YutaSeya/rokisi/hardware/3Dデータ.stl

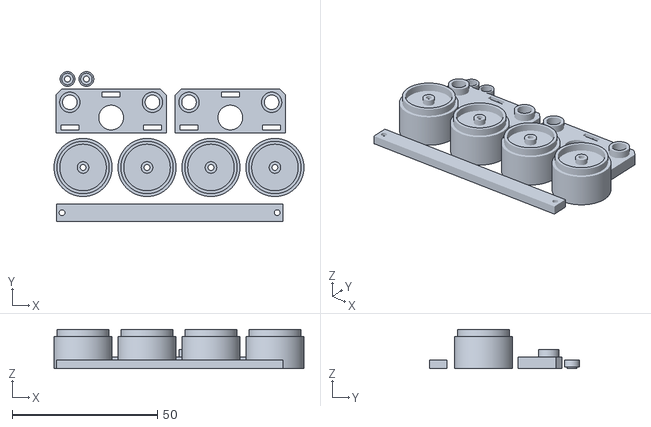
[picture p1: CAD file, 2020-04-21]
hardware/3Dデータ.stl
86.0 x 51.5 x 13.5
