YutaSeya/rokisi/hardware/rokisi/rokisi.pdf

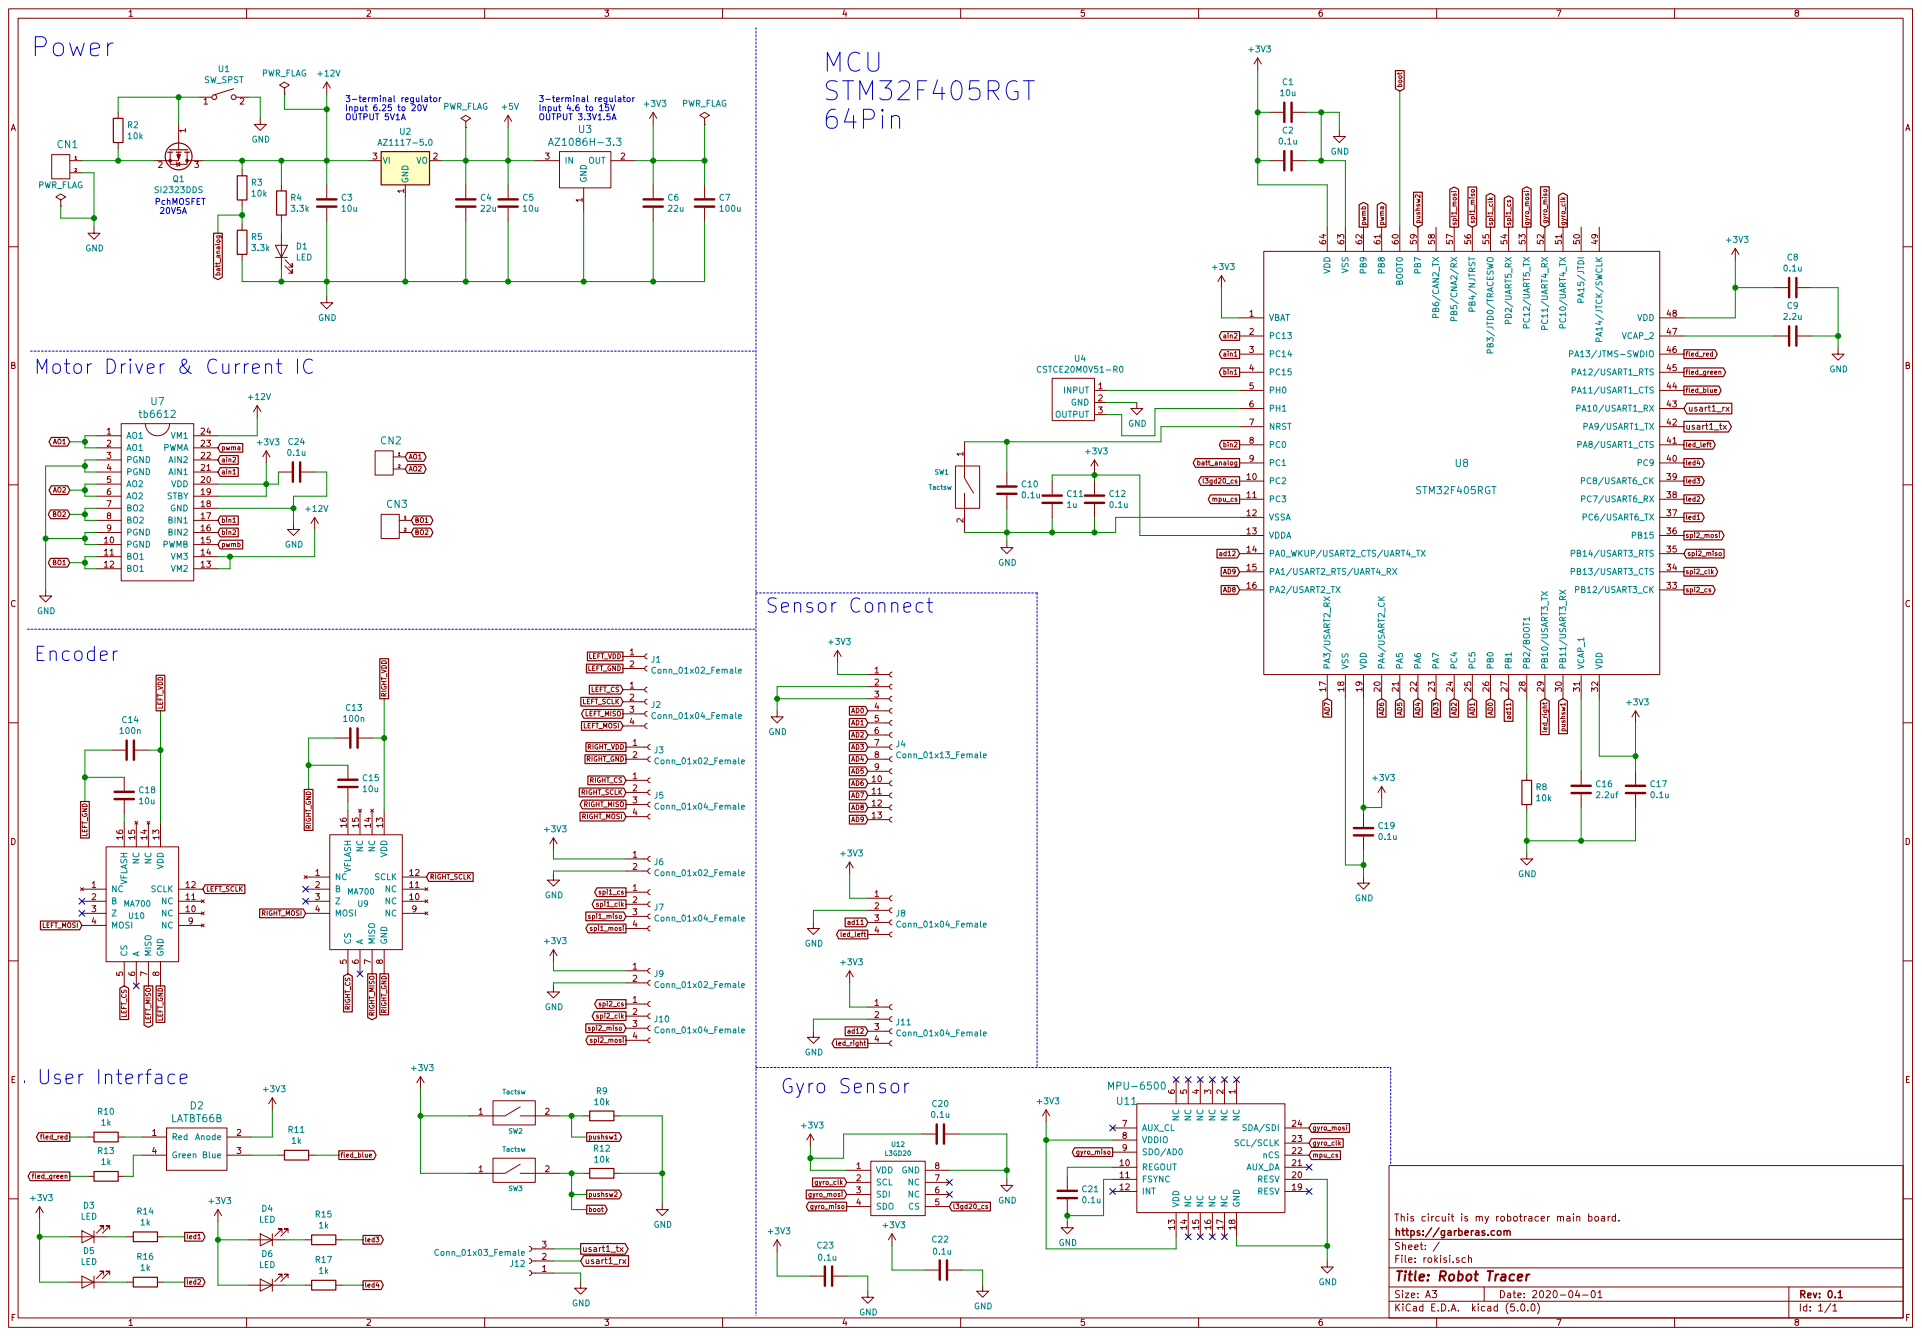
[picture p2: page 1]

bin2 GND Motor Driver & Current IC

This circuit is my robotracer main board.
Id: 1/1 Title: Robot Tracer File: rokisi.sch Sheet: / https://garberas.com
