YutaSeya/rokisi/hardware/rokisi_sensor/rokisi_sensor.pdf

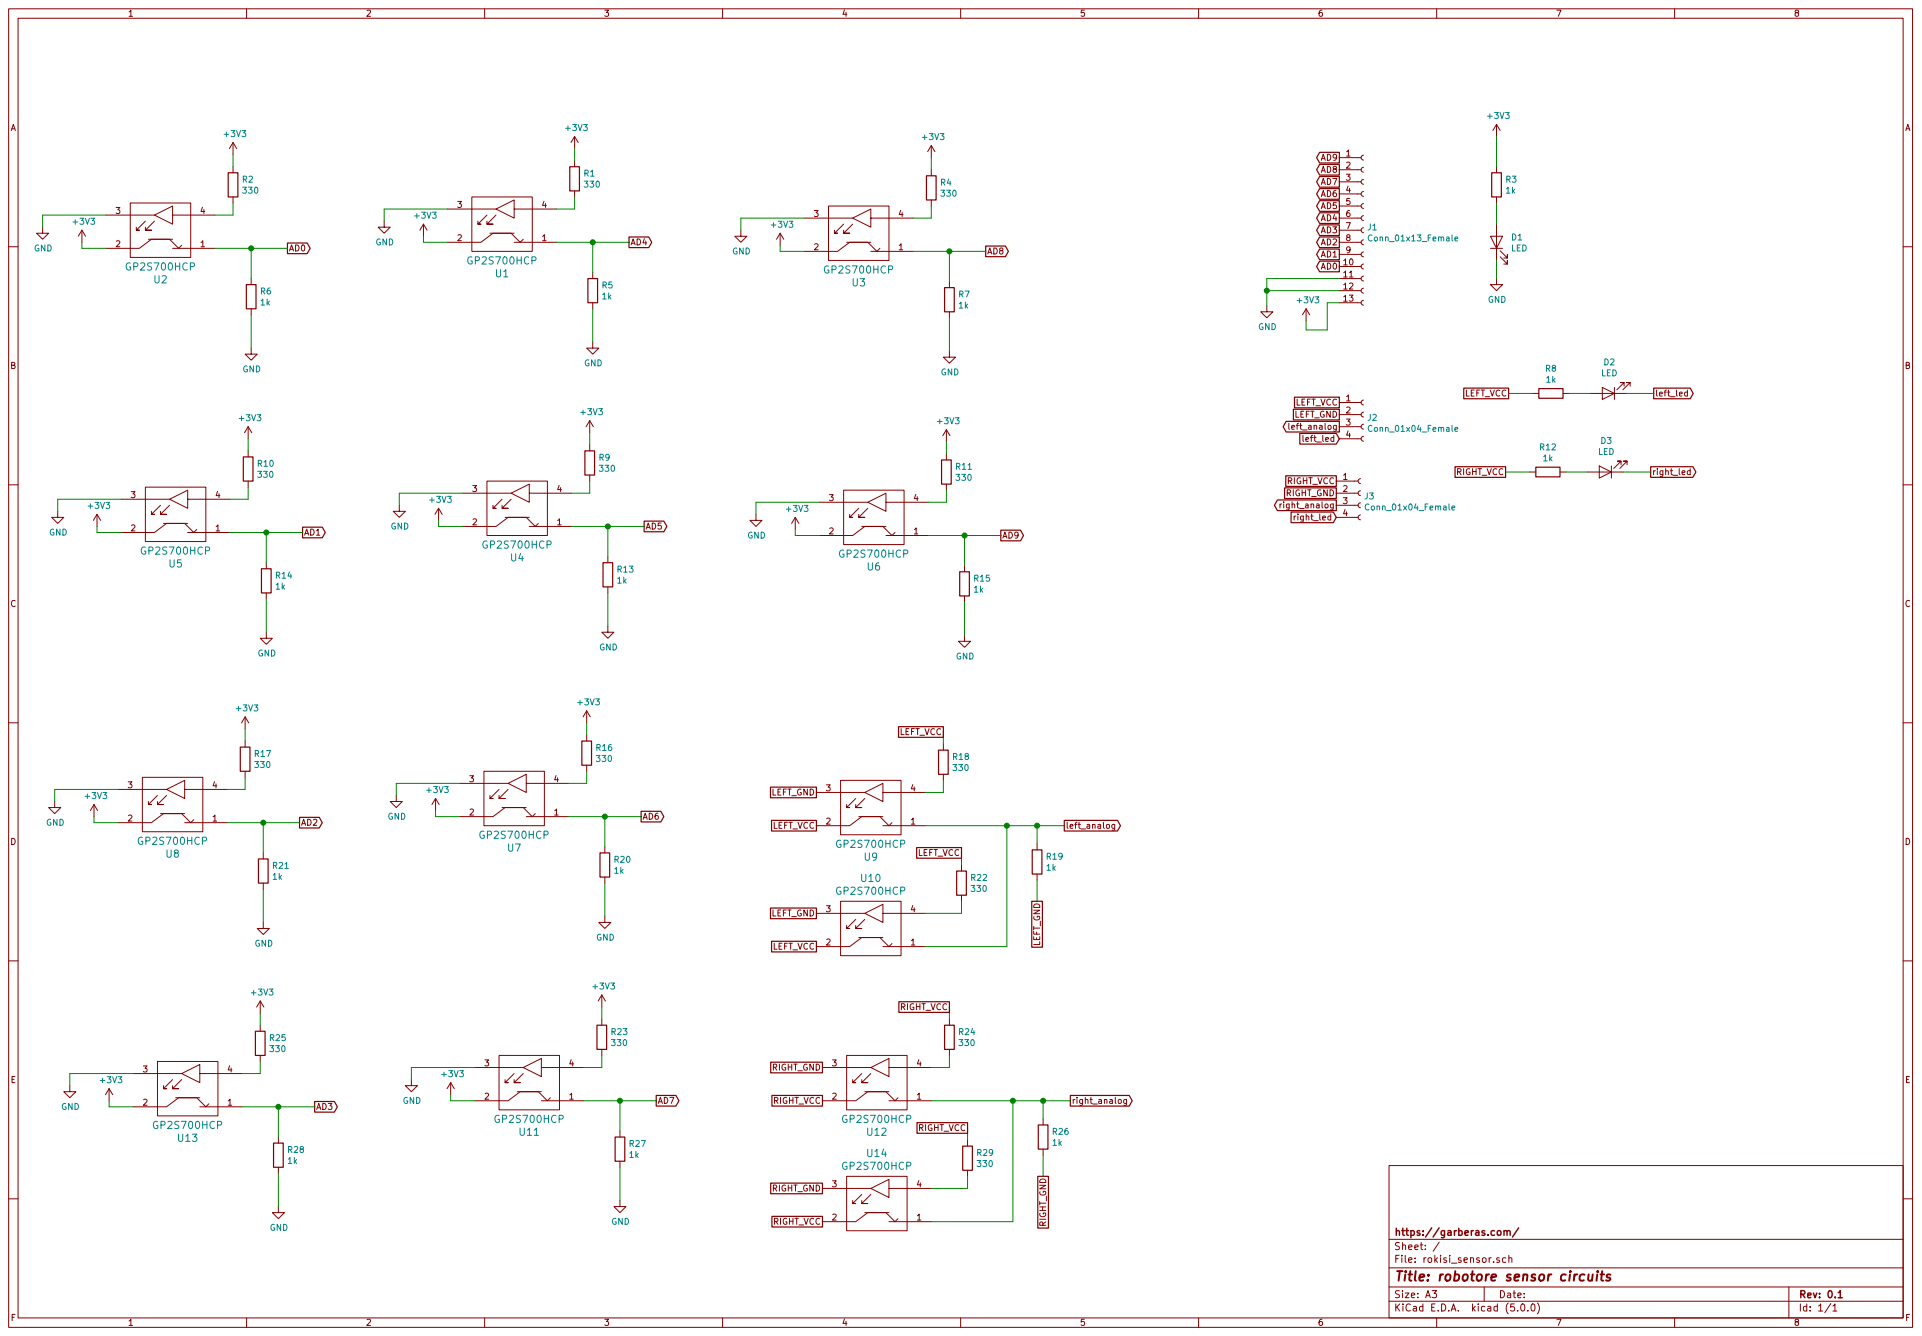
[picture p3: page 1]

File: rokisi_sensor.sch Sheet: / https://garberas.com/

Id: 1/1 Title: robotore sensor circuits
