YutaSeya/rokisi/hardware/rokisi/rokisi.kicad_pcb

## KiCad design hardware/rokisi/rokisi.kicad_pcb (2020-04-18)

Schematic: rokisi.sch, Robot Tracer

Parts:
C1, C3, C5, C15, C18: 10u; C_0603_HandSoldering
C2, C8, C10, C12, C17, C19, C20, C21, C22, C23, C24: 0.1u; C_0603_HandSoldering
C4, C6: 22u; C_0603_HandSoldering
C7: 100u; C_1206_HandSoldering
C9: 2.2u; C_0603_HandSoldering
C11: 1u; C_0603_HandSoldering
C13, C14: 100n; C_0603_HandSoldering
C16: 2.2uf; C_0603_HandSoldering
CN1: CONNECT; Pin_Header_Straight_1x02_Pitch2.54mm
CN2, CN3: CONNECT; Pin_Header_Straight_1x02_Pitch2.00mm
D1: LED; LED_0603_HandSoldering
D2: LATBT66B
D3, D4, D5, D6: LED; LED_0603_HandSoldering_silk
J1, J3, J6, J9: Conn_01x02_Female; enckiban_robotore_pad2
J2, J5, J7, J10: Conn_01x04_Female; enckiban_pad4
J4: Conn_01x13_Female; FFC-SMD_13P-P0.50_X05B20U13T
J8, J11: Conn_01x04_Female; Pin_Header_Straight_1x04_Pitch2.00mm
J12: Conn_01x03_Female; Pin_Header_Straight_1x03_Pitch2.54mm
Q1: SI2323DDS; SOT-23_Handsoldering
R2, R3, R8, R9, R12: 10k; R_0603_HandSoldering
R4, R5: 3.3k; R_0603_HandSoldering
R10, R11, R13, R14, R15, R16, R17: 1k; R_0603_HandSoldering
SW1: Tactsw; B3U-1000P
SW2, SW3: Tactsw; SKRPACE010
U1: SW_SPST; PCM12SMTR
U2: AZ1117-5.0; SOT-223
U3: AZ1086H-3.3; SOT-223
U4: CSTCE20M0V51-R0; CSTCE12M0G52A-R0_HandSolding
U7: tb6612; SSOP-24_5.3x8.2mm_Pitch0.65mm
U8: STM32F405RGT; LQFP-64_10x10mm_Pitch0.5mm
U9, U10: MA700; QFN-16_3x3mm_Pitch0.5mm
U11: MPU-6500; QFN-24_3x3mm_Pitch0.4mm_silk
U12: L3GD20

Connections:
+3V3: C1.2, C2.2, C6.1, C7.1, C8.2, C11.1, C12.1, C17.1, C19.2, C20.2, C22.1, C23.1, C24.2, D2.2, D3.2, D4.2, D5.2, D6.2, J4.1, J6.1, J8.1, J9.1, J11.1, SW2.1, SW3.1, U3.2, U3.4, U7.19, U7.20, U8.1, U8.13, U8.19, U8.32, U8.48, U8.64, U11.8, U11.13, U12.1
+5V: C4.1, C5.1, U2.2 (VO), U2.4, U3.3
+12V: C3.1, Q1.3 (D), R3.1, R4.1, U2.3 (VI), U7.13, U7.14, U7.24
AD0: J4.4, U8.26
AD1: J4.5, U8.25
AD2: J4.6, U8.24
AD3: J4.7, U8.23
AD4: J4.8, U8.22
AD5: J4.9, U8.21
AD6: J4.10, U8.20
AD7: J4.11, U8.17
AD8: J4.12, U8.16
AD9: J4.13, U8.15
AO1: CN2.1, U7.1, U7.2
AO2: CN2.2, U7.5, U7.6
BO1: CN3.1, U7.11, U7.12
BO2: CN3.2, U7.7, U7.8
GND: C1.1, C2.1, C3.2, C4.2, C5.2, C6.2, C7.2, C8.1, C9.1, C10.1, C11.2, C12.2, C16.2, C17.2, C19.1, C20.1, C21.2, C22.2, C23.2, C24.1, CN1.2, D1.1, J4.2, J4.3, J6.2, J8.2, J9.2, J11.2, J12.1, R5.2, R8.2, R9.1, R12.1, SW1.2, U1.2, U2.1 (GND), U3.1, U4.2, U7.3, U7.4, U7.9, U7.10, U7.18, U8.12, U8.18, U8.63, U11.11, U11.18, U11.20, U12.8
LEFT_CS: J2.1, U10.5
LEFT_GND: C14.2, C18.1, J1.2, U10.8
LEFT_MISO: J2.3, U10.7
LEFT_MOSI: J2.4, U10.4
LEFT_SCLK: J2.2, U10.12
LEFT_VDD: C14.1, J1.1, U10.13
unnamed: C9.2, U8.47
unnamed: C10.2, SW1.1, U8.7
unnamed: C15.2, U9.16
unnamed: C16.1, U8.31
unnamed: C18.2, U10.16
unnamed: C21.1, U11.10
unnamed: CN1.1, Q1.2 (S), R2.2
unnamed: D1.2, R4.2
unnamed: D2.1, R10.2
unnamed: D2.3, R11.1
unnamed: D2.4, R13.2
unnamed: D3.1, R14.1
unnamed: D4.1, R15.1
unnamed: D5.1, R16.1
unnamed: D6.1, R17.1
unnamed: Q1.1 (G), R2.1, U1.1
unnamed: R8.1, U8.28
unnamed: U4.1, U8.5
unnamed: U4.3, U8.6
RIGHT_CS: J5.1, U9.5
RIGHT_GND: C13.2, C15.1, J3.2, U9.8
RIGHT_MISO: J5.3, U9.7
RIGHT_MOSI: J5.4, U9.4
RIGHT_SCLK: J5.2, U9.12
RIGHT_VDD: C13.1, J3.1, U9.13
ad11: J8.3, U8.27
ad12: J11.3, U8.14
ain1: U7.21, U8.3
ain2: U7.22, U8.2
batt_analog: R3.2, R5.1, U8.9
bin1: U7.17, U8.4
bin2: U7.16, U8.8
boot: R12.2, SW3.2, U8.59, U8.60
fled_blue: R11.2, U8.44
fled_green: R13.1, U8.45
fled_red: R10.1, U8.46
gyro_clk: U8.51, U11.23, U12.2
gyro_miso: U8.52, U11.9, U12.4
gyro_mosi: U8.53, U11.24, U12.3
l3gd20_cs: U8.10, U12.5
led1: R14.2, U8.37
led2: R16.2, U8.38
led3: R15.2, U8.39
led4: R17.2, U8.40
led_left: J8.4, U8.41
led_right: J11.4, U8.29
mpu_cs: U8.11, U11.22
pushsw1: R9.2, SW2.2, U8.30
pwma: U7.23, U8.61
pwmb: U7.15, U8.62
spi1_clk: J7.2, U8.55
spi1_cs: J7.1, U8.54
spi1_miso: J7.3, U8.56
spi1_mosi: J7.4, U8.57
spi2_clk: J10.2, U8.34
spi2_cs: J10.1, U8.33
spi2_miso: J10.3, U8.35
spi2_mosi: J10.4, U8.36
usart1_rx: J12.2, U8.43
usart1_tx: J12.3, U8.42

Notes on the sheet:
Power
Gyro Sensor
PchMOSFET 20V5A
3-terminal regulator Input 6.25 to 20V OUTPUT 5V1A
3-terminal regulator Input 4.6 to 15V OUTPUT 3.3V1.5A
Motor Driver & Current IC
Encoder
MCU STM32F405RGT 64Pin
User Interface
Sensor Connect

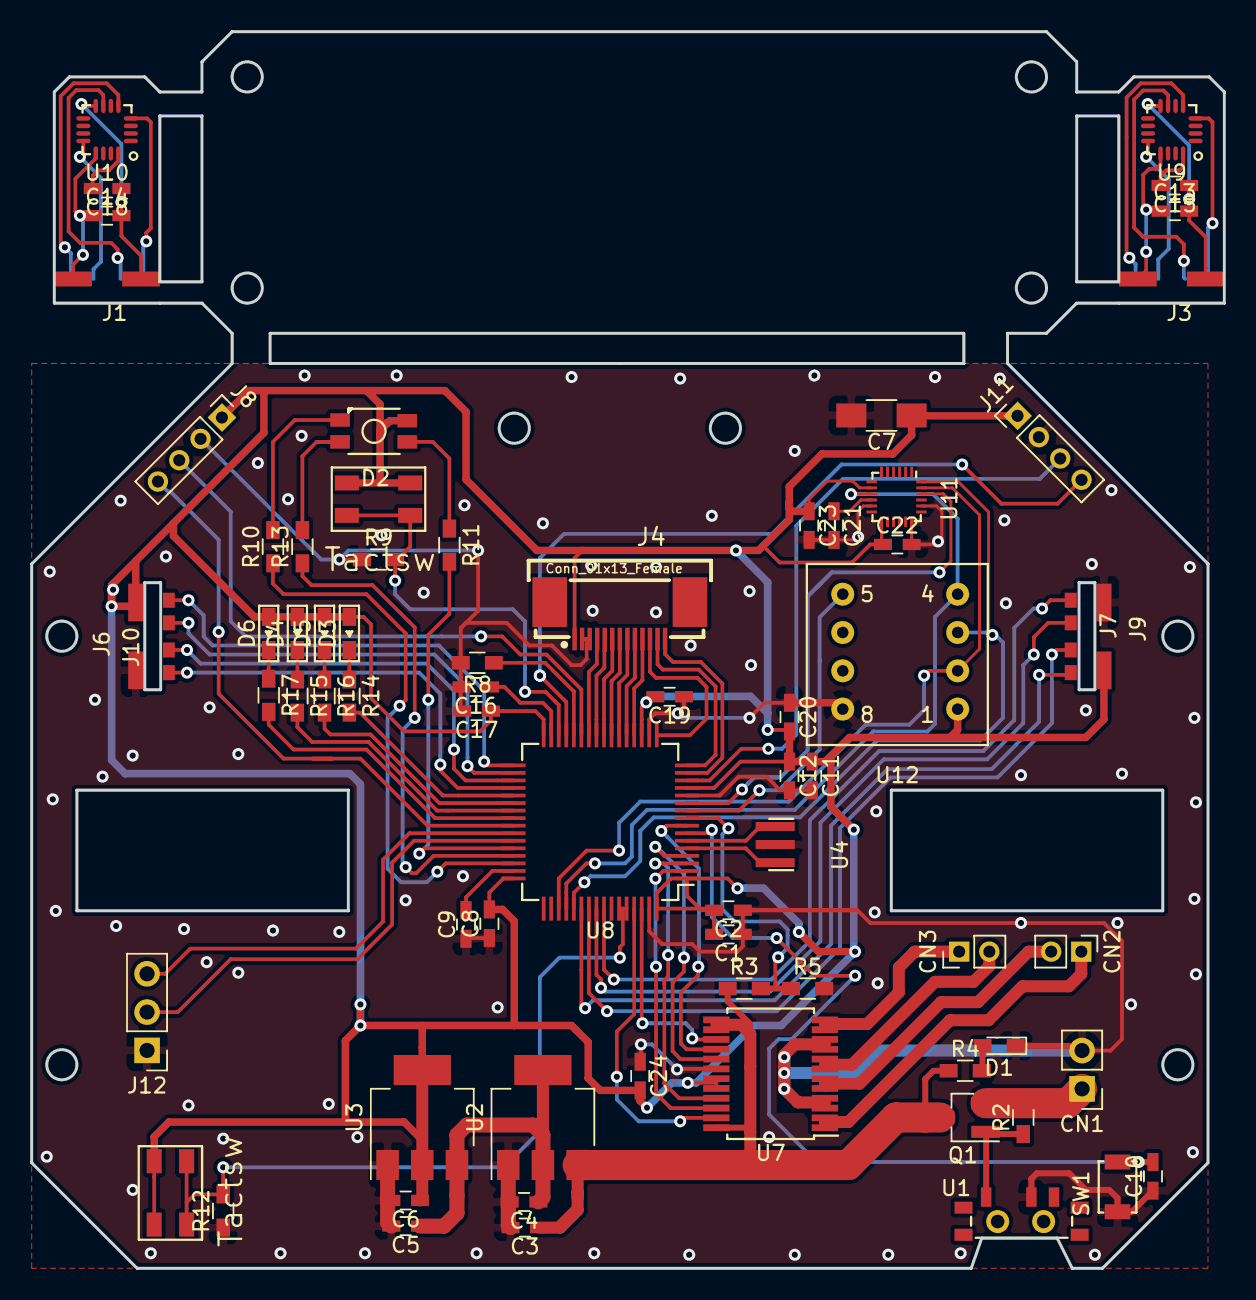
[picture p4: board rokisi.kicad_pcb from above]

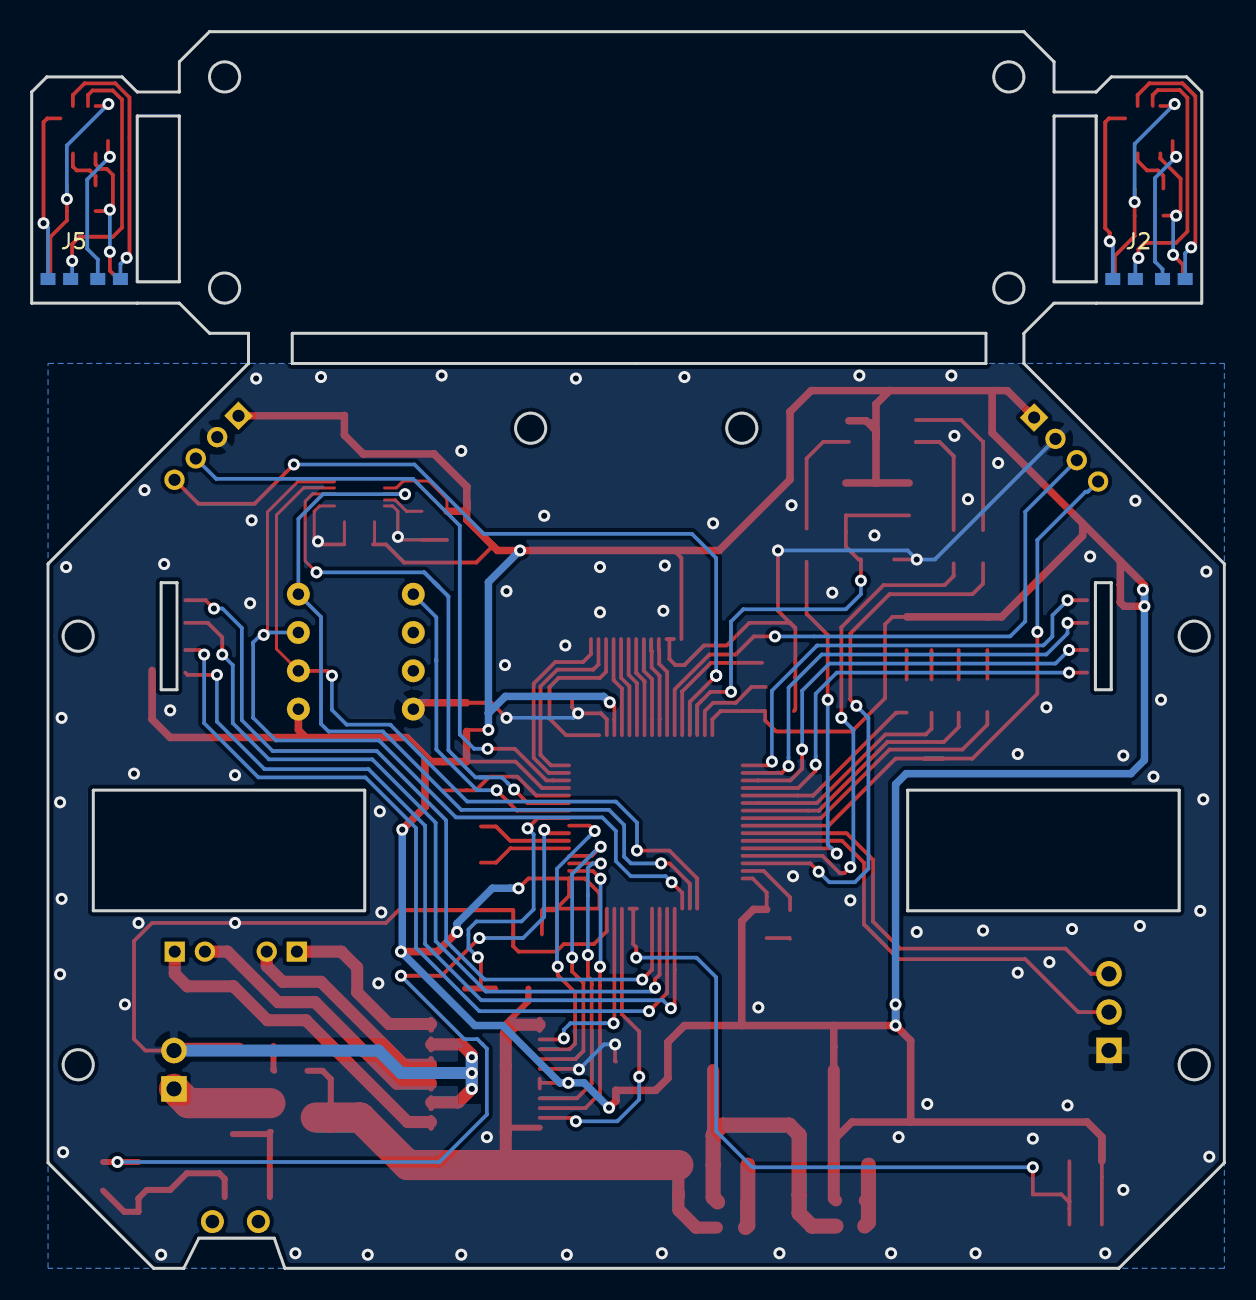
[picture p5: board rokisi.kicad_pcb from below]

Board: 2 copper layers, 79.1 x 82.0 mm, 73 parts (2 on the bottom side), 84 nets.
