YutaSeya/rokisi/hardware/rokisi_sensor/rokisi_sensor.kicad_pcb

## KiCad design hardware/rokisi_sensor/rokisi_sensor.kicad_pcb (2020-04-18)

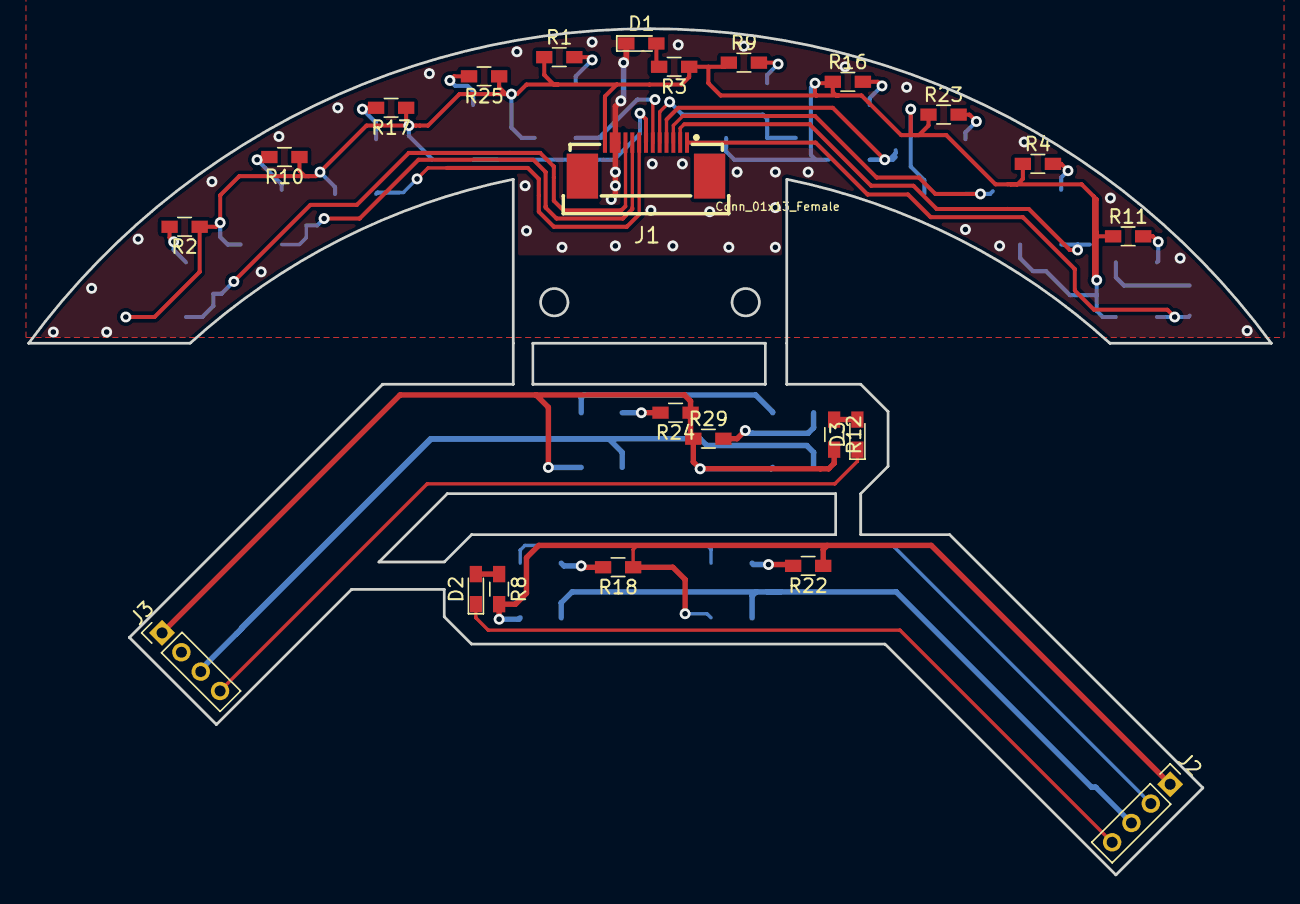
[picture p6: board rokisi_sensor.kicad_pcb from above]

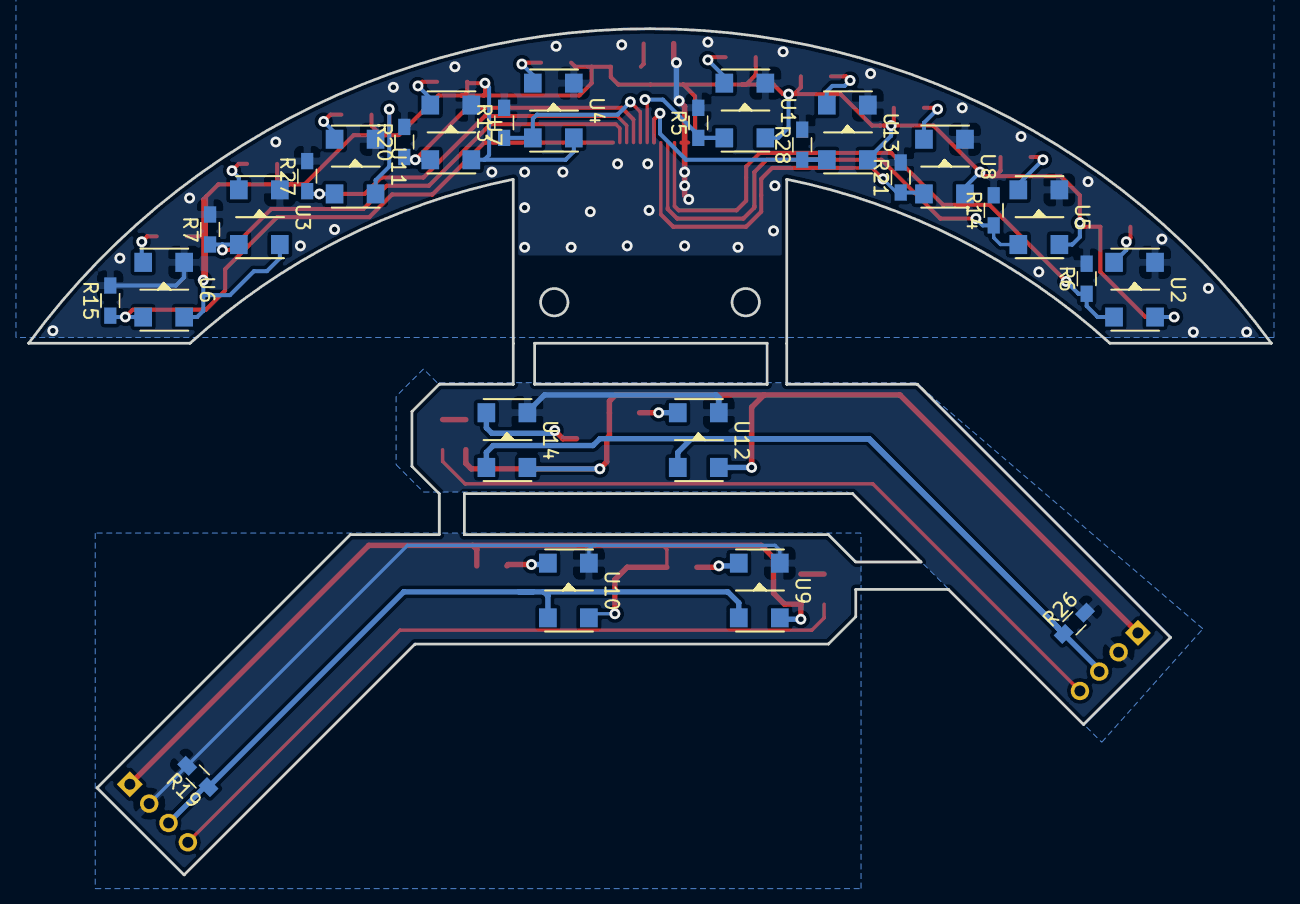
[picture p7: board rokisi_sensor.kicad_pcb from below]

Board: 2 copper layers, 90.9 x 61.9 mm, 49 parts (26 on the bottom side), 37 nets.

Parts:
D1, D2, D3: LED; LED_0603_HandSoldering
J1: Conn_01x13_Female; FFC-SMD_13P-P0.50_X05B20U13T
J2, J3: Conn_01x04_Female; Pin_Header_Straight_1x04_Pitch2.00mm
R1, R2, R4, R9, R10, R11, R16, R17, R18, R22, R23, R24, R25, R29: 330; R_0603_HandSoldering
R3, R5, R6, R7, R8, R12, R13, R14, R15, R19, R20, R21, R26, R27, R28: 1k; R_0603_HandSoldering
U1, U2, U3, U4, U5, U6, U7, U8, U9, U10, U11, U12, U13, U14: GP2S700HCP

Connections:
+3V3: J1.13, R1.1, R2.1, R3.1, R4.1, R9.1, R10.1, R11.1, R16.1, R17.1, R23.1, R25.1, U1.2, U2.2, U3.2, U4.2, U5.2, U6.2, U7.2, U8.2, U11.2, U13.2
AD0: J1.10, R6.1, U2.1
AD1: J1.9, R14.1, U5.1
AD2: J1.8, R21.1, U8.1
AD3: J1.7, R28.1, U13.1
AD4: J1.6, R5.1, U1.1
AD5: J1.5, R13.1, U4.1
AD6: J1.4, R20.1, U7.1
AD7: J1.3, R27.1, U11.1
AD8: J1.2, R7.1, U3.1
AD9: J1.1, R15.1, U6.1
GND: D1.1, J1.11, J1.12, R5.2, R6.2, R7.2, R13.2, R14.2, R15.2, R20.2, R21.2, R27.2, R28.2, U1.3, U2.3, U3.3, U4.3, U5.3, U6.3, U7.3, U8.3, U11.3, U13.3
LEFT_GND: J2.2, R19.2, U9.3, U10.3
LEFT_VCC: J2.1, R8.2, R18.1, R22.1, U9.2, U10.2
unnamed: D1.2, R3.2
unnamed: D2.2, R8.1
unnamed: D3.2, R12.1
unnamed: R1.2, U1.4
unnamed: R2.2, U2.4
unnamed: R4.2, U3.4
unnamed: R9.2, U4.4
unnamed: R10.2, U5.4
unnamed: R11.2, U6.4
unnamed: R16.2, U7.4
unnamed: R17.2, U8.4
unnamed: R18.2, U9.4
unnamed: R22.2, U10.4
unnamed: R23.2, U11.4
unnamed: R24.2, U12.4
unnamed: R25.2, U13.4
unnamed: R29.2, U14.4
RIGHT_GND: J3.2, R26.2, U12.3, U14.3
RIGHT_VCC: J3.1, R12.2, R24.1, R29.1, U12.2, U14.2
left_analog: J2.3, R19.1, U9.1, U10.1
left_led: D2.1, J2.4
right_analog: J3.3, R26.1, U12.1, U14.1
right_led: D3.1, J3.4
