YutaSeya/rokisi/firmware/rokisi.ioc

Mcu.UserName=STM32F405RGTx
PA0-WKUP.Signal=ADCx_IN0
PA1.Signal=ADCx_IN1
PA10.Signal=USART1_RX
PA11.GPIO_Label=fled_blue
PA11.Signal=GPIO_Output
PA12.GPIO_Label=fled_green
PA12.Signal=GPIO_Output
PA13.GPIO_Label=fled_red
PA13.Signal=GPIO_Output
PA2.GPIO_Label=led_right
PA2.Signal=GPIO_Output
PA3.GPIO_Label=fetb
PA3.Signal=GPIO_Output
PA4.Signal=ADCx_IN4
PA5.Signal=ADCx_IN5
PA6.Signal=ADCx_IN6
PA7.Signal=ADCx_IN7
PA8.GPIO_Label=fet_side_left
PA8.Signal=GPIO_Output
PA9.Signal=USART1_TX
PB0.GPIO_Label=feta
PB0.Signal=GPIO_Output
PB1.Signal=ADCx_IN9
PB10.GPIO_Label=fet_side_right
PB10.Signal=GPIO_Output
PB11.GPIO_Label=pushsw1
PB11.Signal=GPIO_Input
PB12.GPIO_Label=enc_left_cs
PB12.Signal=GPIO_Output
PB13.Signal=SPI2_SCK
PB14.Signal=SPI2_MISO
PB15.Signal=SPI2_MOSI
PB3.Signal=SPI1_SCK
PB4.Signal=SPI1_MISO
PB5.Signal=SPI1_MOSI
PB7.GPIO_Label=pushsw2
PB7.Signal=GPIO_Input
PB8.Signal=S_TIM4_CH3
PB9.Signal=S_TIM4_CH4
PC0.GPIO_Label=bin2
PC0.Signal=GPIO_Output
PC1.Signal=ADCx_IN11
PC10.Signal=SPI3_SCK
PC11.Signal=SPI3_MISO
PC12.Signal=SPI3_MOSI
PC13-ANTI_TAMP.GPIO_Label=ain2
PC13-ANTI_TAMP.Signal=GPIO_Output
PC14-OSC32_IN.GPIO_Label=ain1
PC14-OSC32_IN.Signal=GPIO_Output
PC15-OSC32_OUT.GPIO_Label=bin1
PC15-OSC32_OUT.Signal=GPIO_Output
PC2.GPIO_Label=l3gd20_cs
PC2.Signal=GPIO_Output
PC3.GPIO_Label=mpu_cs
PC3.Signal=GPIO_Output
PC4.Signal=ADCx_IN14
PC5.GPIO_Label=led_left
PC5.Signal=GPIO_Output
PC6.GPIO_Label=led1
PC6.Signal=GPIO_Output
PC7.GPIO_Label=led2
PC7.Signal=GPIO_Output
PC8.GPIO_Label=led3
PC8.Signal=GPIO_Output
PC9.GPIO_Label=led4
PC9.Signal=GPIO_Output
PD2.GPIO_Label=enc_right_cs
PD2.Signal=GPIO_Output
PH0-OSC_IN.Signal=RCC_OSC_IN
PH1-OSC_OUT.Signal=RCC_OSC_OUT
