YutaSeya/rokisi/firmware/Inc/main.h

#define ain2_Pin LL_GPIO_PIN_13
#define ain2_GPIO_Port GPIOC
#define ain1_Pin LL_GPIO_PIN_14
#define ain1_GPIO_Port GPIOC
#define bin1_Pin LL_GPIO_PIN_15
#define bin1_GPIO_Port GPIOC
#define bin2_Pin LL_GPIO_PIN_0
#define bin2_GPIO_Port GPIOC
#define l3gd20_cs_Pin LL_GPIO_PIN_2
#define l3gd20_cs_GPIO_Port GPIOC
#define mpu_cs_Pin LL_GPIO_PIN_3
#define mpu_cs_GPIO_Port GPIOC
#define led_right_Pin LL_GPIO_PIN_2
#define led_right_GPIO_Port GPIOA
#define fetb_Pin LL_GPIO_PIN_3
#define fetb_GPIO_Port GPIOA
#define led_left_Pin LL_GPIO_PIN_5
#define led_left_GPIO_Port GPIOC
#define feta_Pin LL_GPIO_PIN_0
#define feta_GPIO_Port GPIOB
#define fet_side_right_Pin LL_GPIO_PIN_10
#define fet_side_right_GPIO_Port GPIOB
#define pushsw1_Pin LL_GPIO_PIN_11
#define pushsw1_GPIO_Port GPIOB
#define enc_left_cs_Pin LL_GPIO_PIN_12
#define enc_left_cs_GPIO_Port GPIOB
#define led1_Pin LL_GPIO_PIN_6
#define led1_GPIO_Port GPIOC
#define led2_Pin LL_GPIO_PIN_7
#define led2_GPIO_Port GPIOC
#define led3_Pin LL_GPIO_PIN_8
#define led3_GPIO_Port GPIOC
#define led4_Pin LL_GPIO_PIN_9
#define led4_GPIO_Port GPIOC
#define fet_side_left_Pin LL_GPIO_PIN_8
#define fet_side_left_GPIO_Port GPIOA
#define fled_blue_Pin LL_GPIO_PIN_11
#define fled_blue_GPIO_Port GPIOA
#define fled_green_Pin LL_GPIO_PIN_12
#define fled_green_GPIO_Port GPIOA
#define fled_red_Pin LL_GPIO_PIN_13
#define fled_red_GPIO_Port GPIOA
#define enc_right_cs_Pin LL_GPIO_PIN_2
#define enc_right_cs_GPIO_Port GPIOD
#define pushsw2_Pin LL_GPIO_PIN_7
#define pushsw2_GPIO_Port GPIOB
#define NVIC_PRIORITYGROUP_0         ((uint32_t)0x00000007) /*!< 0 bit  for pre-emption priority,
#define NVIC_PRIORITYGROUP_1         ((uint32_t)0x00000006) /*!< 1 bit  for pre-emption priority,
#define NVIC_PRIORITYGROUP_2         ((uint32_t)0x00000005) /*!< 2 bits for pre-emption priority,
#define NVIC_PRIORITYGROUP_3         ((uint32_t)0x00000004) /*!< 3 bits for pre-emption priority,
#define NVIC_PRIORITYGROUP_4         ((uint32_t)0x00000003) /*!< 4 bits for pre-emption priority,
