YutaSeya/rokisi/(commit log)

2020-04-18 init commit
    [3Dデータ.stl, rokisi.kicad_pcb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]
2020-04-21 update readme and 3D data
    [3Dデータ.stl]
